has1on/esp32-staffroom-call/HARDWARE_WORKSHEET.md

# 实物确认表（未确认项不通电）

套别：______ 日期：______ 负责人：______

## Audio

- N16R8 板型号 / 版本、GPIO 对照资料：______
- microSD 模组 VIN / 信号电平依据：______
- PCM5102A 模组 VIN、三线 I2S、SCK、静音 / 格式跳线依据：______
- 有源喇叭型号与 AUX：______

| 程序参数 | 实物 GPIO | 对端丝印 / 接头 | 核对人 |
| --- | --- | --- | --- |
| PIN_SD_CS | | | |
| PIN_SD_SCK | | | |
| PIN_SD_MISO | | | |
| PIN_SD_MOSI | | | |
| PIN_I2S_BCLK | | | |
| PIN_I2S_LRCK | | | |
| PIN_I2S_DATA | | | |

共地与电压 / 极性核实：______ USB / 外部供电隔离规则：______

## Door

型号确为 7B / 版本：______ 显示 / 触控 / TF 官方示例：______

实际板型 / Flash / PSRAM / USB 接口：______

## Matrix

板型号 / 版本 N32R16：______ 屏 64×32 / 驱动 IC：______

扫描方式 / 行映射：______ HUB75 IN 与 pin1：______

电源额定值 / 接头 / 线材 / 保护：______

成功官方示例、clkphase、driver：______

## 网络（此表不填密码）

| 角色 | MAC | 实际保留 IP | systemId |
| --- | --- | --- | --- |
| Door | | | |
| Audio | | | |
| Matrix | | | |

受管 2.4GHz、设备互通、TCP80、无互联网端口映射：______

## 安全锁

AUDIO_PINS_CONFIRMED / PANEL_CONFIRMED 只在上述项核实后改 true。

确认签名：______ 尚未解决项目：______

## 交货运行模式与验收证据

Door STAFFROOM_UI_DEMO=0：____；Audio AUDIO_TEST_STAGE=0：____

USE_CHIME与根目录文件一致：____；两卡版本/校验：____

Audio stage1读卡日志：____；stage2实际听到语句：____

一小时开始/结束/叫号数：____；正式位置声光可读性：____

所有密码/密钥均另行受管保存，本表不得填写。

## 網絡新版驗收（不填密碼/PIN）

认证方法/CA提供人：____；是否允许设备间TCP80 / mDNS：____
管理PIN保管人：____；Door IP/MAC页核对：____
同步Door/Audio結果：____；Matrix单配记录：____
是否使用NVS/恢复演练：____；搬位/冷启动结果：____
IP数字WAV校验/实际试听：____（缺素材注明改用串口）
学生5位/前导零/E别名碰撞检查：____
原优化版保留目录/新私有升级目录/回退资料：____
