has1on/esp32-staffroom-call/sd_templates/AUDIO/students/README.txt

这里只放学生录音；未附虚假语音。学生片段必须读“姓名＋同学找”，或按指南加公共词片段。先备份已有 TF 卡，再按 audioFile 指定路径放置。
