has1on/esp32-staffroom-call/sd_templates/AUDIO/teachers/README.txt

这里只放老师录音，例 01.wav 读“李老师”。老师编号和 teachers.csv 必须一致。
