has1on/esp32-staffroom-call/assets/network-status.png

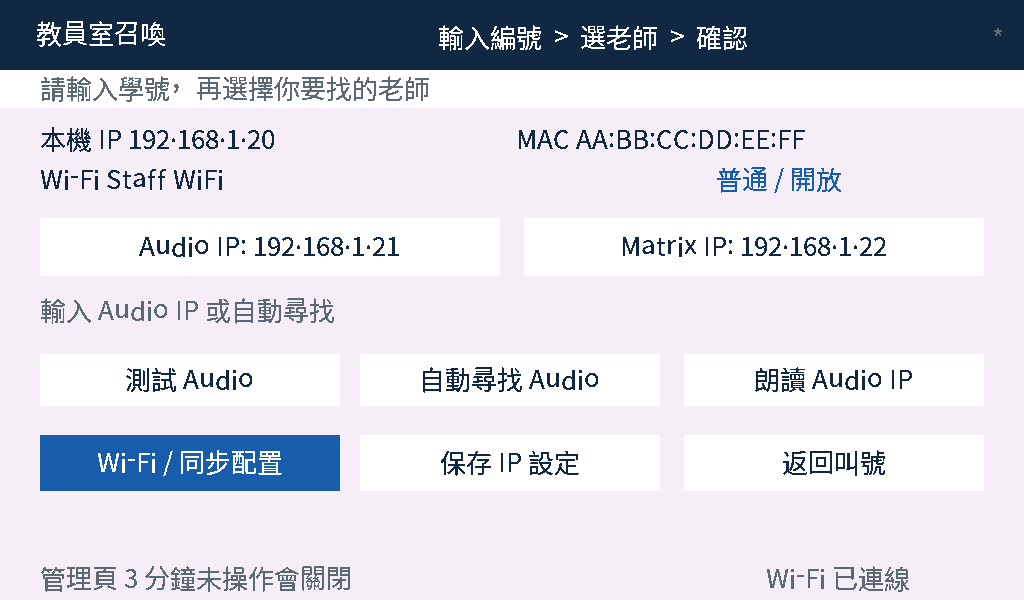
assets/network-status.png
