has1on/esp32-staffroom-call/assets/preview-home.png

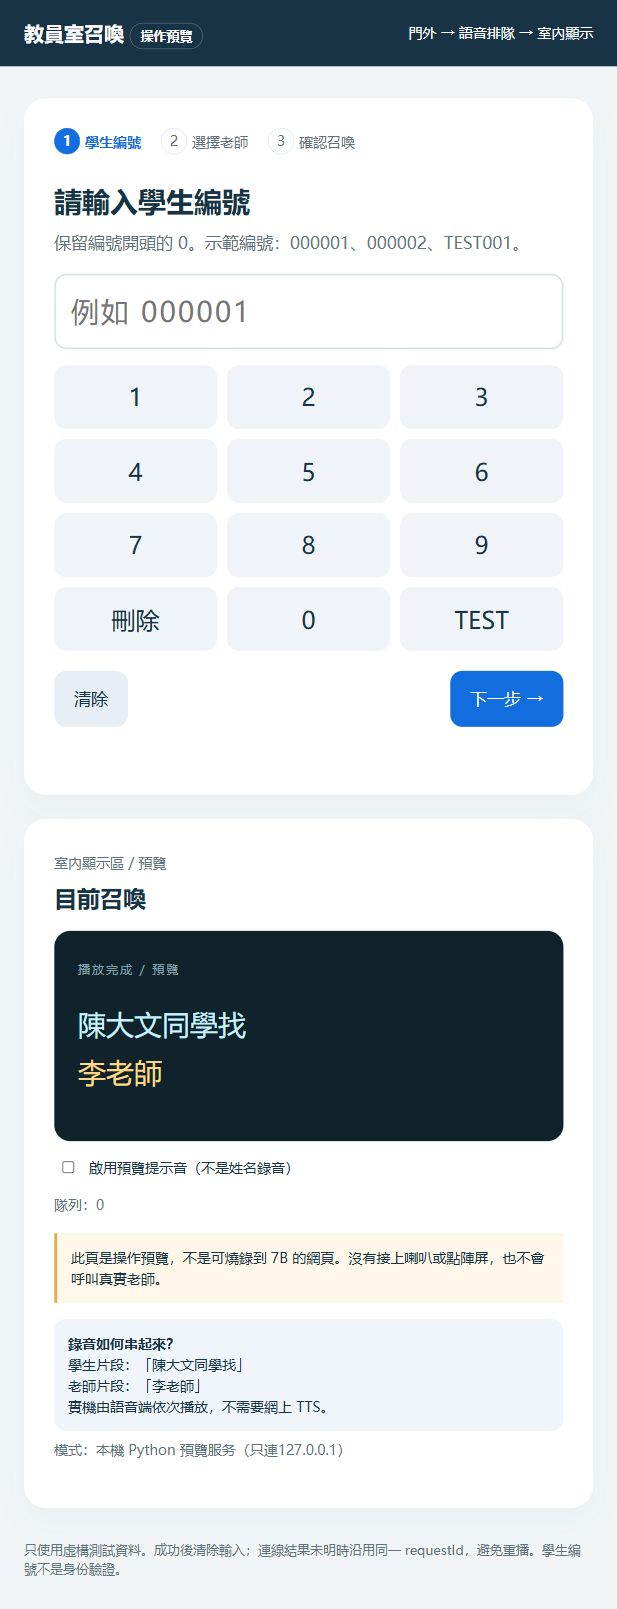
assets/preview-home.png
