has1on/esp32-staffroom-call/assets/preview-guide.png

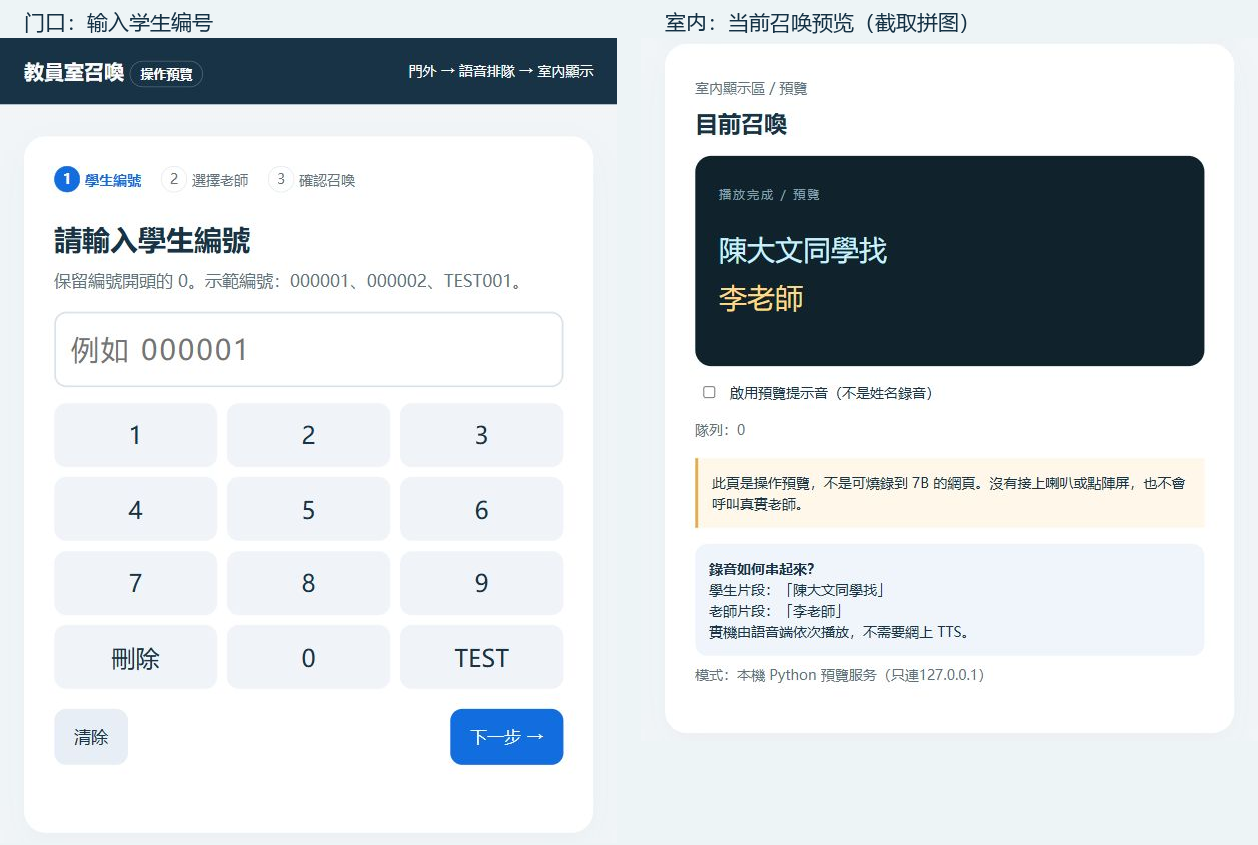
assets/preview-guide.png
