has1on/esp32-staffroom-call/sd_first_test/AUDIO/students.csv

studentId | class | maskedName | displayName | audioFile
99999 | TEST | 測○生 | 測試學生 | /students/TEST001.wav
