has1on/esp32-staffroom-call/sd_first_test/AUDIO/teachers.csv

teacherId | displayName | audioFile
01 | 李老師 | /teachers/01.wav
