has1on/esp32-staffroom-call/sd_first_test/DOOR/students.csv

studentId | class | maskedName
99999 | TEST | 測○生
