has1on/esp32-staffroom-call/sd_first_test/DOOR/teachers.csv

teacherId | displayName
01 | 李老師
