has1on/esp32-staffroom-call/firmware/Door/glyphs.h

// Generated bitmap subset. Font: Noto Sans CJK / SIL OFL.
// Regenerate with tools/generate_fonts.py after any roster or banner change.
#pragma once
#include <stdint.h>
constexpr int GLYPH_SIZE=28;
struct Glyph{uint32_t code;uint8_t advance;uint8_t bits[98];};
static const Glyph GLYPHS[]={
{32,6,{0,0,0,0,0,0,0,0,0,0,0,0,0,0,0,0,0,0,0,0,0,0,0,0,0,0,0,0,0,0,0,0,0,0,0,0,0,0,0,0,0,0,0,0,0,0,0,0,0,0,0,0,0,0,0,0,0,0,0,0,0,0,0,0,0,0,0,0,0,0,0,0,0,0,0,0,0,0,0,0,0,0,0,0,0,0,0,0,0,0,0,0,0,0,0,0,0,0}},
{33,8,{0,0,0,0,0,0,0,0,0,0,0,0,0,0,24,0,0,1,128,0,0,24,0,0,1,128,0,0,24,0,0,1,128,0,0,24,0,0,1,128,0,0,24,0,0,1,128,0,0,24,0,0,1,128,0,0,24,0,0,1,128,0,0,0,0,0,0,0,0,0,24,0,0,1,192,0,0,60,0,0,1,128,0,0,0,0,0,0,0,0,0,0,0,0,0,0,0,0}},
{34,12,{0,0,0,0,0,0,0,0,0,0,0,0,0,0,57,192,0,3,156,0,0,57,192,0,3,156,0,0,56,192,0,1,140,0,0,24,192,0,1,8,0,0,0,0,0,0,0,0,0,0,0,0,0,0,0,0,0,0,0,0,0,0,0,0,0,0,0,0,0,0,0,0,0,0,0,0,0,0,0,0,0,0,0,0,0,0,0,0,0,0,0,0,0,0,0,0,0,0}},
{35,14,{0,0,0,0,0,0,0,0,0,0,0,0,0,0,6,48,0,0,67,0,0,12,48,0,0,195,0,0,12,32,0,3,255,128,0,127,252,0,0,198,0,0,12,96,0,0,134,0,0,8,96,0,7,255,128,0,127,248,0,1,132,0,0,24,192,0,1,140,0,0,24,192,0,1,12,0,0,16,192,0,0,0,0,0,0,0,0,0,0,0,0,0,0,0,0,0,0,0}},
{36,14,{0,0,0,0,48,0,0,3,0,0,0,48,0,0,7,192,0,1,255,0,0,28,48,0,3,128,0,0,56,0,0,3,128,0,0,56,0,0,1,224,0,0,15,128,0,0,60,0,0,1,240,0,0,7,0,0,0,56,0,0,3,128,0,0,56,0,2,3,128,0,56,112,0,3,254,0,0,15,192,0,0,48,0,0,3,0,0,0,48,0,0,0,0,0,0,0,0,0}},
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
};
constexpr int GLYPH_COUNT=sizeof(GLYPHS)/sizeof(GLYPHS[0]);
