has1on/esp32-staffroom-call/firmware/Matrix/glyphs.h

// Generated bitmap subset. Font: Noto Sans CJK / SIL OFL.
// Regenerate with tools/generate_fonts.py after any roster or banner change.
#pragma once
#include <stdint.h>
constexpr int GLYPH_SIZE=16;
struct Glyph{uint32_t code;uint8_t advance;uint8_t bits[32];};
static const Glyph GLYPHS[]={
{32,3,{0,0,0,0,0,0,0,0,0,0,0,0,0,0,0,0,0,0,0,0,0,0,0,0,0,0,0,0,0,0,0,0}},
{33,5,{0,0,0,0,32,0,96,0,32,0,32,0,32,0,32,0,32,0,32,0,0,0,96,0,96,0,0,0,0,0,0,0}},
{34,7,{0,0,0,0,104,0,104,0,104,0,104,0,0,0,0,0,0,0,0,0,0,0,0,0,0,0,0,0,0,0,0,0}},
{35,8,{0,0,0,0,0,0,4,0,36,0,36,0,126,0,36,0,36,0,254,0,36,0,104,0,72,0,0,0,0,0,0,0}},
{36,8,{0,0,24,0,24,0,60,0,96,0,96,0,96,0,24,0,12,0,6,0,6,0,102,0,60,0,24,0,0,0,0,0}},
{37,13,{0,0,0,0,112,192,72,128,201,128,201,0,75,96,90,144,52,144,4,144,8,144,8,144,16,96,0,0,0,0,0,0}},
{38,10,{0,0,0,0,28,0,36,0,36,0,44,0,56,0,48,128,121,128,205,0,199,0,103,128,61,128,0,0,0,0,0,0}},
{39,4,{0,0,0,0,96,0,96,0,96,0,96,0,0,0,0,0,0,0,0,0,0,0,0,0,0,0,0,0,0,0,0,0}},
{40,5,{0,0,16,0,48,0,32,0,32,0,96,0,96,0,96,0,96,0,96,0,96,0,32,0,32,0,16,0,16,0,0,0}},
{41,5,{0,0,64,0,64,0,96,0,32,0,32,0,32,0,48,0,48,0,32,0,32,0,32,0,96,0,64,0,64,0,0,0}},
{42,7,{0,0,0,0,16,0,120,0,56,0,56,0,0,0,0,0,0,0,0,0,0,0,0,0,0,0,0,0,0,0,0,0}},
{43,8,{0,0,0,0,0,0,0,0,24,0,24,0,24,0,254,0,24,0,24,0,24,0,0,0,0,0,0,0,0,0,0,0}},
{44,4,{0,0,0,0,0,0,0,0,0,0,96,0,96,0,32,0,96,0,0,0,0,0,0,0,0,0,0,0,0,0,0,0}},
{45,5,{0,0,0,0,0,0,0,0,0,0,0,0,112,0,0,0,0,0,0,0,0,0,0,0,0,0,0,0,0,0,0,0}},
{46,4,{0,0,0,0,0,0,0,0,0,0,0,0,0,0,96,0,96,0,0,0,0,0,0,0,0,0,0,0,0,0,0,0}},
{47,6,{0,0,8,0,8,0,24,0,16,0,16,0,16,0,32,0,32,0,32,0,64,0,64,0,64,0,192,0,128,0,0,0}},
{48,8,{0,0,0,0,56,0,100,0,70,0,66,0,66,0,66,0,66,0,66,0,70,0,100,0,56,0,0,0,0,0,0,0}},
{49,8,{0,0,0,0,56,0,56,0,24,0,24,0,24,0,24,0,24,0,24,0,24,0,24,0,126,0,0,0,0,0,0,0}},
{50,8,{0,0,0,0,56,0,76,0,6,0,6,0,4,0,12,0,12,0,24,0,48,0,96,0,126,0,0,0,0,0,0,0}},
{51,8,{0,0,0,0,60,0,108,0,6,0,6,0,12,0,56,0,6,0,6,0,6,0,70,0,124,0,0,0,0,0,0,0}},
{52,8,{0,0,0,0,12,0,12,0,28,0,52,0,36,0,100,0,68,0,254,0,4,0,4,0,4,0,0,0,0,0,0,0}},
{53,8,{0,0,0,0,126,0,96,0,96,0,96,0,124,0,6,0,6,0,2,0,6,0,196,0,124,0,0,0,0,0,0,0}},
{54,8,{0,0,0,0,28,0,50,0,96,0,64,0,92,0,102,0,66,0,66,0,98,0,38,0,28,0,0,0,0,0,0,0}},
{55,8,{0,0,0,0,126,0,6,0,4,0,12,0,8,0,24,0,24,0,24,0,16,0,16,0,16,0,0,0,0,0,0,0}},
{56,8,{0,0,0,0,60,0,102,0,102,0,102,0,52,0,60,0,102,0,66,0,66,0,102,0,60,0,0,0,0,0,0,0}},
{57,8,{0,0,0,0,56,0,100,0,70,0,66,0,66,0,102,0,62,0,6,0,6,0,76,0,120,0,0,0,0,0,0,0}},
{58,4,{0,0,0,0,0,0,0,0,96,0,96,0,0,0,0,0,0,0,0,0,96,0,96,0,0,0,0,0,0,0,0,0}},
{59,4,{0,0,0,0,0,0,96,0,96,0,0,0,0,0,0,0,96,0,96,0,32,0,96,0,0,0,0,0,0,0,0,0}},
{60,8,{0,0,0,0,0,0,0,0,6,0,60,0,96,0,112,0,30,0,2,0,0,0,0,0,0,0,0,0,0,0,0,0}},
{61,8,{0,0,0,0,0,0,0,0,254,0,0,0,0,0,254,0,0,0,0,0,0,0,0,0,0,0,0,0,0,0,0,0}},
{62,8,{0,0,0,0,0,0,0,0,224,0,56,0,6,0,14,0,120,0,192,0,0,0,0,0,0,0,0,0,0,0,0,0}},
{63,7,{0,0,0,0,120,0,76,0,12,0,12,0,8,0,16,0,16,0,16,0,0,0,48,0,48,0,0,0,0,0,0,0}},
{64,13,{0,0,0,0,7,192,24,96,48,16,103,144,76,144,72,144,73,144,73,176,78,224,96,0,48,0,15,128,0,0,0,0}},
{65,9,{0,0,0,0,24,0,28,0,28,0,52,0,38,0,38,0,98,0,126,0,67,0,195,0,193,0,0,0,0,0,0,0}},
{66,9,{0,0,0,0,126,0,99,0,99,0,99,0,99,0,126,0,99,0,97,128,97,128,99,0,126,0,0,0,0,0,0,0}},
{67,9,{0,0,0,0,30,0,51,0,96,0,96,0,64,0,64,0,64,0,96,0,96,0,51,0,30,0,0,0,0,0,0,0}},
{68,10,{0,0,0,0,124,0,103,0,97,0,97,128,97,128,97,128,97,128,97,128,97,0,103,0,124,0,0,0,0,0,0,0}},
{69,8,{0,0,0,0,126,0,96,0,96,0,96,0,96,0,126,0,96,0,96,0,96,0,96,0,127,0,0,0,0,0,0,0}},
{70,8,{0,0,0,0,126,0,96,0,96,0,96,0,96,0,126,0,96,0,96,0,96,0,96,0,96,0,0,0,0,0,0,0}},
{71,10,{0,0,0,0,31,0,49,0,96,0,96,0,64,0,71,128,65,128,97,128,97,128,49,128,31,0,0,0,0,0,0,0}},
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
};
constexpr int GLYPH_COUNT=sizeof(GLYPHS)/sizeof(GLYPHS[0]);
